SuperCoolAlan/system76-launch/kailh-switch-tester3.webp

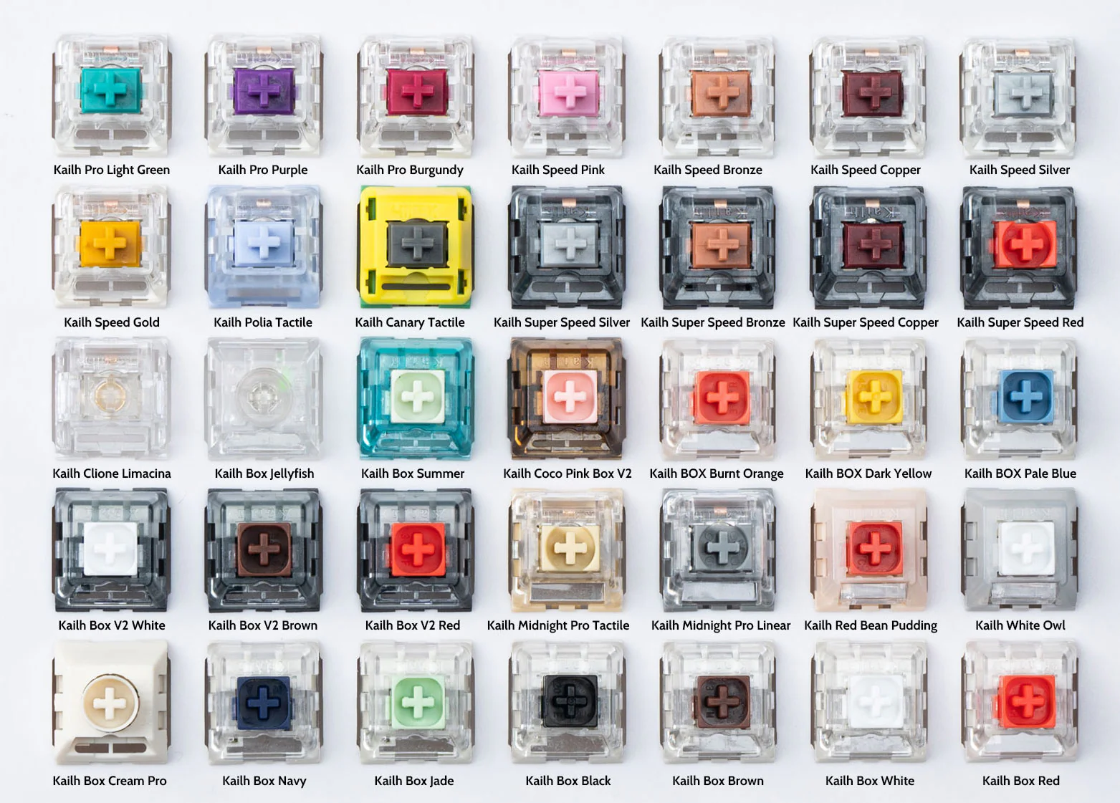
kailh-switch-tester3.webp
