SuperCoolAlan/system76-launch/chassis/launch/CAD Components to Print/fullkeyboard.3mf

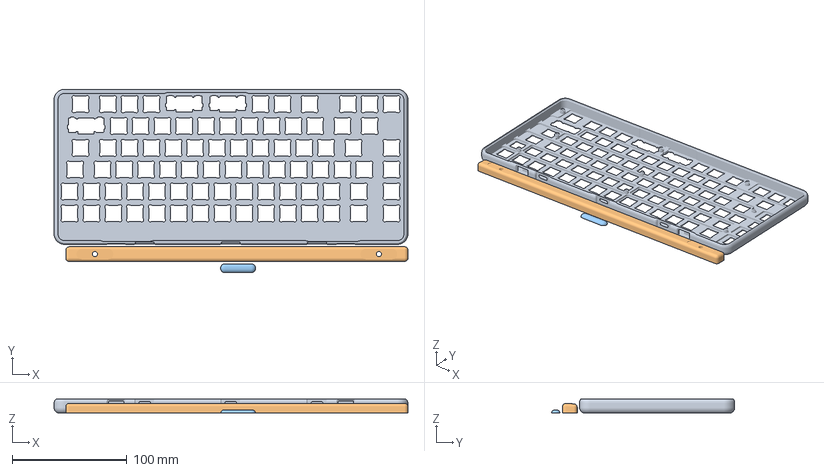
[picture p2: CAD file, 2026-03-03]
chassis/launch/CAD Components to Print/fullkeyboard.3mf
308.3 x 159.7 x 12.6 mm
source-disign-Launch Production v86Upper Housing.step
source-disign-Launch Production v86Angle Bar V7 v7.step
source-disign-Launch Production v86TPU Foot v009.step
