SuperCoolAlan/system76-launch/chassis/launch/CAD Components to Print/bottomframe.3mf

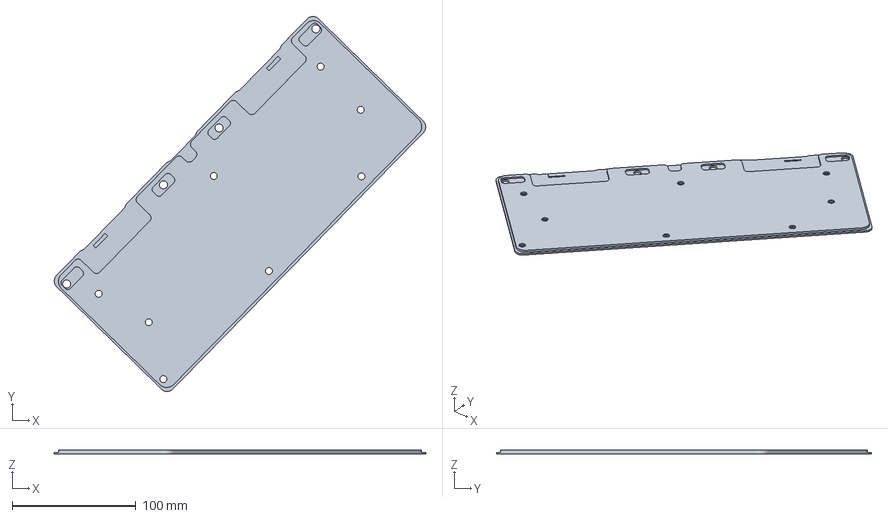
[picture p3: CAD file, 2026-03-03]
chassis/launch/CAD Components to Print/bottomframe.3mf
300.0 x 302.8 x 3.18 mm
