SuperCoolAlan/system76-launch/chassis/launch/CAD Components to Print/Bambu_Test.3mf

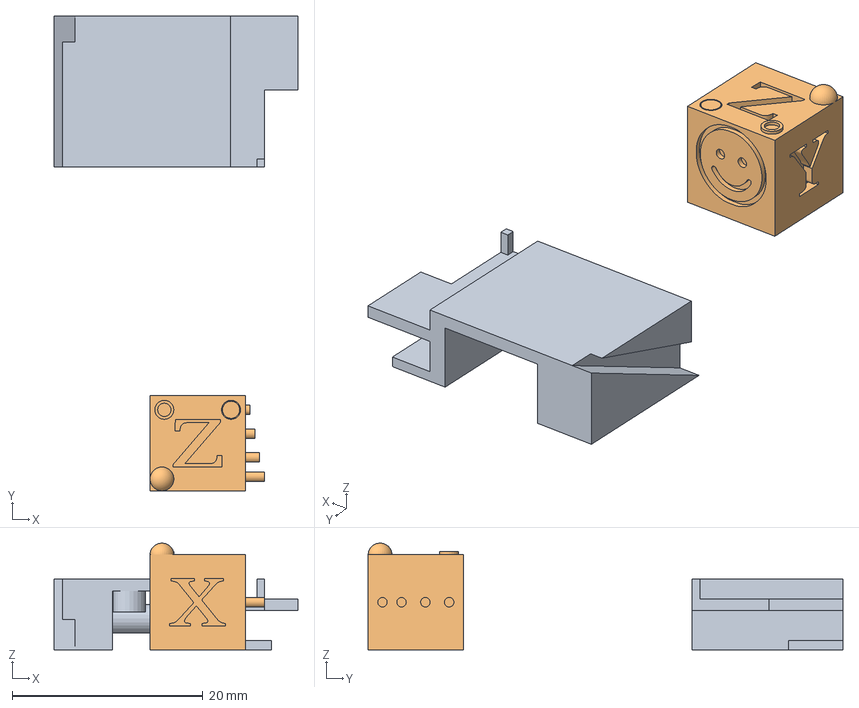
[picture p4: CAD file, 2026-03-03]
chassis/launch/CAD Components to Print/Bambu_Test.3mf
25.6 x 49.8 x 11.2 mm
test.stl
SmallTestCube.stl
