SuperCoolAlan/system76-launch/chassis/launch/CAD Components to Print/transparent-test.3mf

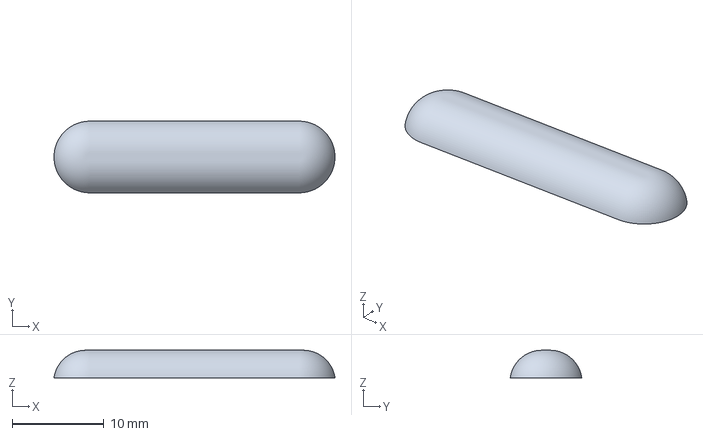
[picture p5: CAD file, 2026-03-03]
chassis/launch/CAD Components to Print/transparent-test.3mf
30.6 x 7.80 x 3.00 mm
