SuperCoolAlan/system76-launch/(list of files, cad)

Other CAD files:
chassis/launch/Bambu Prints/feet.step
chassis/launch/CAD Components to Print/Unnamed-Launch Production v86Upper Housing.step
pcb/models/LED_1515.FCStd
chassis/launch/Bambu Prints/angle bar.step
pcb/models/USB7206.FCStd
chassis/launch/Bambu Prints/Bambu-Launch-Launch Production v86Lower Housing V1 v53.step
pcb/models/SOD128.FCStd
chassis/launch/Bambu Prints/bambu-steel-blank.step
chassis/launch/CAD Components to Print/source-disign-Launch Production v86TPU Foot v009.step
pcb/models/PTN5110.FCStd
chassis/launch/Bambu Prints/bottomframe.3mf
chassis/launch/CAD Components to Print/source-disign-Launch Production v86Upper Housing.step
pcb/models/OSC_2.5x3.2.FCStd
pcb/models/PUSB3FR4.FCStd
chassis/launch/Bambu Prints/bambu-bottomframe.step
pcb/models/GT-TC025D-H0065.FCStd
chassis/launch/Bambu Prints/topframe.step
chassis/launch/CAD Components to Print/source-disign-Launch Production v86Lower Housing V1 v53.step
pcb/models/AFC07-S20FCC-00.FCStd
chassis/launch/CAD Components to Print/source-disign-Launch Production v86Angle Bar V7 v7.step
chassis/launch/Bambu Prints/bambu-isolation-screwmount.3mf
chassis/launch/Bambu Prints/bambu-isolation-screwmount.step
chassis/launch/Bambu Prints/bambu-steel-blank.3mf
chassis/launch/Bambu Prints/topframe.3mf
chassis/launch/CAD Components to Print/source-disign-Launch Production v86Angle Bar V7 v7.3mf
