SuperCoolAlan/system76-launch/(commit log)

2026-02-04 Add hybrid BOM for Mouser and LCSC sourcing
    Split BOM into two distributors to balance cost and availability:
    - Mouser: specialty ICs (RP2040, USB hub, PD controllers, ESD protection)
    - LCSC: passives, common ICs, LEDs, connectors, oscillator
    Kailh hot-swap sockets sourced separately from AliExpress.
    150uF polymer caps (C44-C47) require manual Mouser search.
    [hybrid-lcsc.csv, lcsc-import.csv, mouser-import.csv, mouser.csv]
2026-02-04 Update hybrid BOM with exact quantities and part replacements
    - Set all quantities to exact per-board values from KiCad BOM
    - Replace backordered LCSC resistors:
    - C25744 -> C2889342 (10k)
    - C11702 -> C2889341 (1k)
    - C25752 -> C114760 (12k)
    - Add 25MHz oscillator C405480 to LCSC (was on Mouser)
    - Replace unavailable polymer cap with Nichicon 647-PCW0J151MCO1GS
    [hybrid-lcsc.csv, lcsc-import.csv, mouser-import.csv, mouser.csv]
2026-02-04 Split BOMs into mouser-max and lcsc-max variants for cost comparison
    - mouser-max: Maximizes Mouser sourcing (17 parts) to minimize tariffs
    - lcsc-max: Maximizes LCSC sourcing (34 parts) to minimize component cost
    - Replaced unavailable resistors C2889342/C2889341 with YAGEO C60490/C106235
    - Added Nichicon PCW0J151MCO1GS as replacement for backordered polymer caps
    [lcsc-import.csv, lcsc.csv, mouser-import.csv, mouser.csv]
2026-02-04 Scale BOMs for 5 PCBs with manufacturing attrition
    - Added Qty/Board column to track per-board requirements
    - Order Qty calculated for 5 boards + attrition buffer
    - 20% attrition for 0402/0603 passives
    - 10% attrition for small ICs (SOT-23, SC-70, DFN) and LEDs
    - Exact quantities for large ICs, connectors, inductors
    [lcsc-import.csv, lcsc.csv, mouser-import.csv, mouser.csv]
2026-02-04 Move 25MHz oscillator from LCSC to Mouser due to stock limits
    - LCSC C405480 (ECS-3225MV-250-CN-TR) only had 4 units available
    - Replaced with Mouser 70-XO23C3EREHX25M000 (Vishay XO-23C)
    - Both 3.3V, 25MHz, HCMOS, 3.2x2.5mm package - fully compatible
    [lcsc-import.csv, lcsc.csv, mouser-import.csv, mouser.csv]
2026-02-04 Add cost comparison with final checkout totals
    lcsc-max ($225.94) is $8.72 cheaper than mouser-max ($234.66)
    [cost-comparison.csv]
2026-02-04 Add cost-min BOM variant and update cost comparison
    Final comparison (with shipping/taxes):
    - lcsc-max: $228.71 (winner)
    - cost-min: $230.25
    - mouser-max: $241.66
    cost-min cherry-picks cheapest vendor per part but doesn't
    beat lcsc-max due to shipping/fee overhead.
    [compare.csv, cost-comparison.csv, lcsc-import.csv, lcsc.csv, mouser-import.csv, mouser.csv]
2026-03-03 Add manufacturing files, chassis prints, and clean up old BOMs
    Add PnP position files, gerbers, stencil, feeder plan, and nozzle plan
    for LumenPnP manufacturing. Add chassis Bambu/FreeCAD print files.
    Remove superseded BOM comparison variants. Add .DS_Store and .FCBak
    to gitignore.
    [Bambu-Launch-Launch Production v86Lower Housing V1 v53.step, Bambu_Test.3mf, Unnamed-Launch Production v86Upper Housing.step, angle bar.step, bambu-bottomframe.step, bambu-isolation-screwmount.3mf, bambu-isolation-screwmount.step, bambu-steel-blank.3mf]
2026-03-03 Track FCStd files with Git LFS
    [AFC07-S20FCC-00.FCStd, GT-TC025D-H0065.FCStd, LED_1515.FCStd, OSC_2.5x3.2.FCStd, PTN5110.FCStd, PUSB3FR4.FCStd, SOD128.FCStd, USB7206.FCStd]
2026-03-03 Add PCB side column to feeder plan
    [feeder-plan.csv]
2026-03-07 Add OpenPnP machine config with Launch package definitions
    20 component packages with footprints and nozzle assignments:
    - N045: C_0402, R_0402
    - N08: C_0603, R_0603, LED_SK6805-EC15, D_SOD-128, SOT-23,
    SOT-23-5, SOT-23-6, SOT-353_SC-70-5, SOT-563, DFN-10,
    Oscillator 3.2x2.5mm
    - N14: C_0805, QFN-16 2.6x2.6mm, QFN-20 2.5x4.5mm
    - N24: SRN4018 inductor, SOIC-8 5.3x5.3mm
    - N40: QFN-56 7x7mm (RP2040)
    - N75: QFN-100 12x12mm (USB7206C)
    Footprints sourced from KiCad library and project footprints,
    non-Launch packages removed.
2026-03-07 Update OpenPnP config after v2.6 upgrade
    - Fresh LumenPnP v4-00 machine.xml and vision-settings.xml
    - Restored calibrated camera settings (USB IDs, units-per-pixel,
    rotation, exposure, head offsets)
    - New OpenPnP added through-board-depth attributes to parts
2026-03-07 Save first clean OpenPnP v2.6 calibration
    Nozzle head offsets, homing fiducial position, bottom camera
    position, and N045 nozzle tip calibration pipeline updated
    from initial machine setup.
2026-03-07 Update N045 calibration and vacuum levels
    N045 runout compensation recalibrated (peak error 0.265 -> 0.016mm),
    vacuum sensing thresholds tuned for N045 and N08.
2026-03-07 Assign top-side feeder slots and update part numbers from orders
    - Assign slots 1-10 (motorized) and S1-S6 (strip) for top-side pass
    - Update part numbers to match actual LCSC/Mouser orders (subs for 0.1uF, 1nF, 330pF, 27pF)
    - Reclassify PMEG3030EP as 12mm strip feeder (unassigned pending 3D print)
    - Sync machine.xml with latest vacuum tuning from OpenPnP
    [feeder-plan.csv]
2026-03-07 Add motorized feeder slot 1 config and strip feeders
2026-03-08 Add OpenPnP Part Name column to feeder plan and shift motorized slots up one
    Slot 1 reserved for discard pile. Motorized feeders now start at slot 2.
    [feeder-plan.csv]
2026-03-10 Add PhotonFeeders for slots 3-6 and update calibration
    Configure 0.1uF cap, 10k resistor, and 52.3k resistor feeders with
    pick offsets. Set slot locations for 3, 4, and fix slot 6. Update
    nozzle tip runout compensation and vision pipeline parameters.
2026-03-10 Tune feeder pick offsets, slot locations, and nozzle calibration
    Adjust pick Y offsets for all 4 PhotonFeeders and add Z offset for
    10k resistor feeder. Refine slot 2/4/6 positions. Update nozzle
    runout compensation and lower N045 vacuum-level-part-on-high to 226.
2026-03-10 Add PhotonFeeders for slot 7 (RGB LEDs) and slot 8 (2.2uF 0603)
    Configure SK6805-EC15 LED feeder and 2.2uF 0603 cap feeder with
    4mm part pitch. Set slot 7/8 locations and update nozzle calibration.
2026-03-18 Add slot 10 PhotonFeeder, fix S1 strip part, remove duplicate part
    - Add PhotonFeeder for slot 10 (AP22811AW5-7 load switch)
    - Fix S1 strip feeder part assignment from 1uF to 1nF
    - Remove duplicate AP22811AW5-7 part with invisible Unicode char from parts.xml
    - Add missing-parts.csv to track 0603WAF100LT5E (0.1Ω) needed for slot 9
    [missing-parts.csv]
2026-03-25 Move 0.1 ohm 0603 to strip feeder S7, clear missing parts
    [feeder-plan.csv, missing-parts.csv]
2026-03-25 Fix bottom camera: reset format-id, exposure, and brightness
    Resolved USB path mismatch (00.4 → 00.3) and switched bottom camera
    to MJPG 1080p 30fps (format-id 13).
2026-03-25 Restore camera exposure settings, bottom cam format-id to MJPG 1080p
    Bottom camera re-added after removal; calibration matrix needs redo.
2026-03-25 Restore bottom camera calibration matrix and distortion coefficients
2026-03-25 Fix homing fiducial location, tighten fiducial min-diameter to 50px
    Nudged homing Y by -0.1mm, raised fiducial detection min-diameter
    from 10 to 50 to avoid false matches on nearby pads. Also re-ran
    nozzle runout calibration for N045 and N08.
2026-03-25 Add PhotonFeeder slot 5 (100k 0402), strip feeders S2 and S7
    Configured PhotonFeeder for 100k resistor in slot 5, set up strip
    feeders for 43k 0402 (S2) and 0.1 ohm 0603 (S7).
2026-03-25 Add S3 strip feeder (499 ohm 0402), tweak S2 location
2026-03-26 Tune PhotonFeeder slot locations and strip feeder positions
    Re-calibrated slot locations for feeders 2-4, 6, 8. Nudged S1 Y position.
2026-03-26 Add PhotonFeeder slot 11 for SN74LVC1G08DCKR AND gate
2026-03-26 Fix N045 nozzle calibration pipeline, raise min-diameter to 20px
    RMS error dropped from 0.42mm to 0.014mm after filtering out small
    false circle detections.
